prsalikut/wro-2026/other/prototyping/_final_montage.jpg

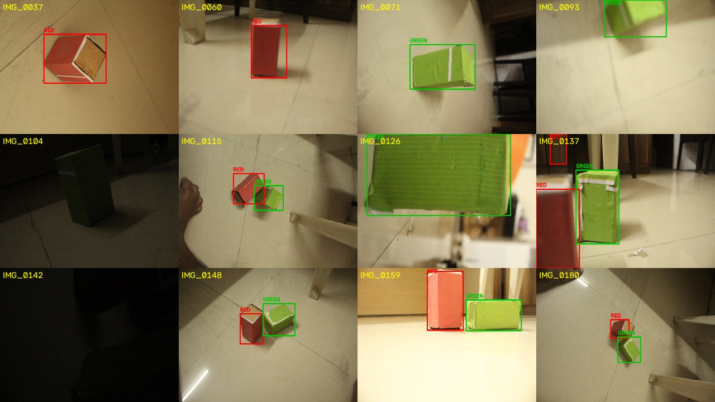
other/prototyping/_final_montage.jpg
