prsalikut/wro-2026/dataset/wro_dataset/_review_sheet_1.jpg

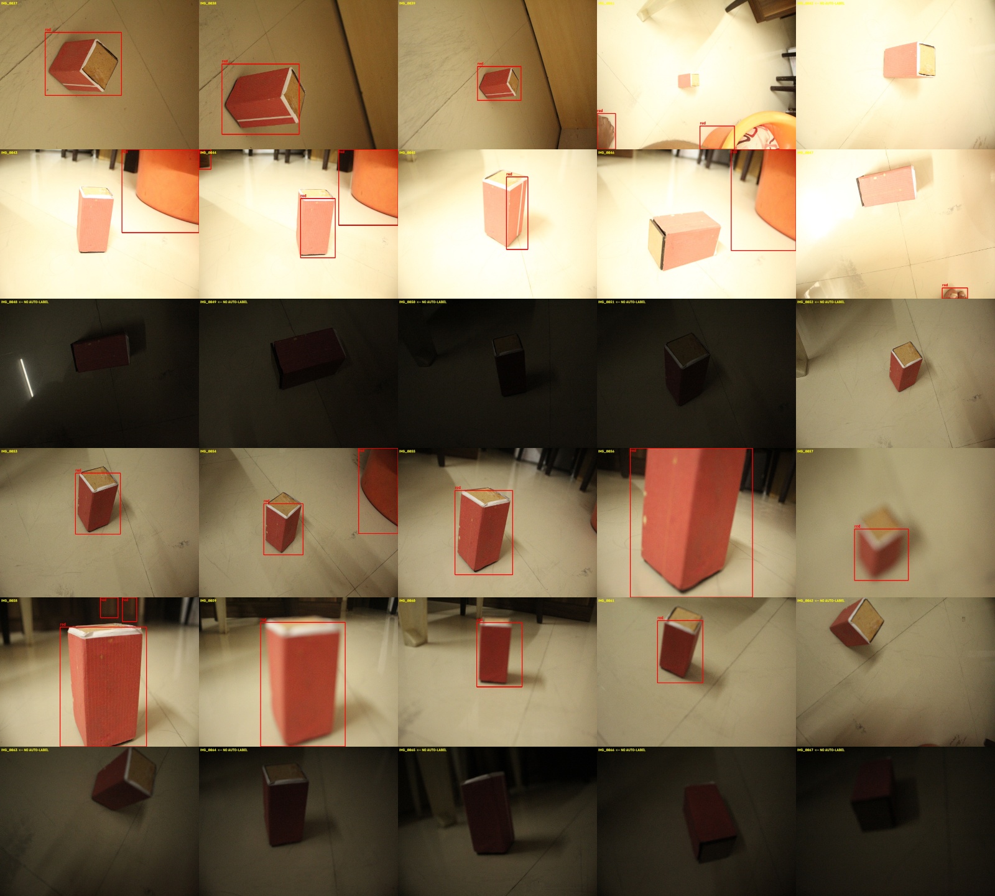
dataset/wro_dataset/_review_sheet_1.jpg
