prsalikut/wro-2026/dataset/wro_dataset/train/images/IMG_0037.jpg

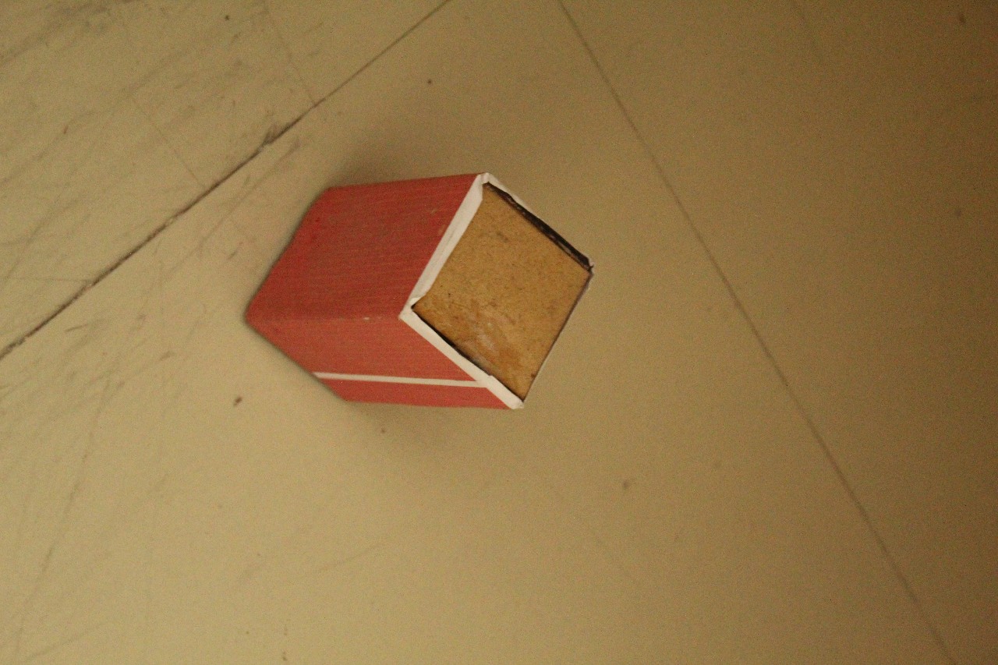
dataset/wro_dataset/train/images/IMG_0037.jpg
