prsalikut/wro-2026/dataset/wro_dataset/train/images/IMG_0073.jpg

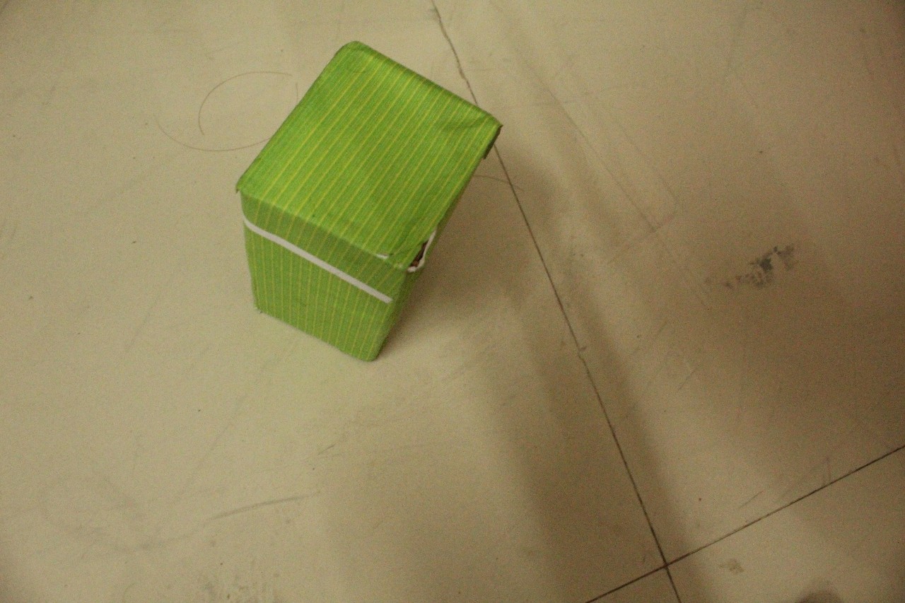
dataset/wro_dataset/train/images/IMG_0073.jpg
