prsalikut/wro-2026/dataset/wro_dataset/train/images/IMG_0081.jpg

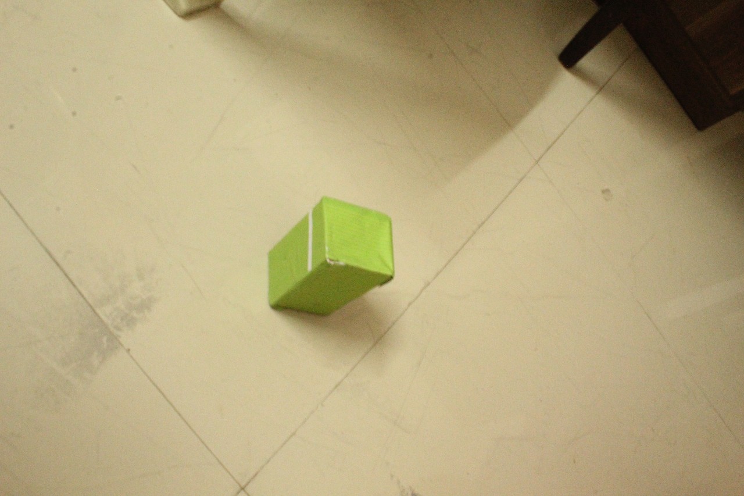
dataset/wro_dataset/train/images/IMG_0081.jpg
