prsalikut/wro-2026/dataset/wro_dataset/train/images/IMG_0092.jpg

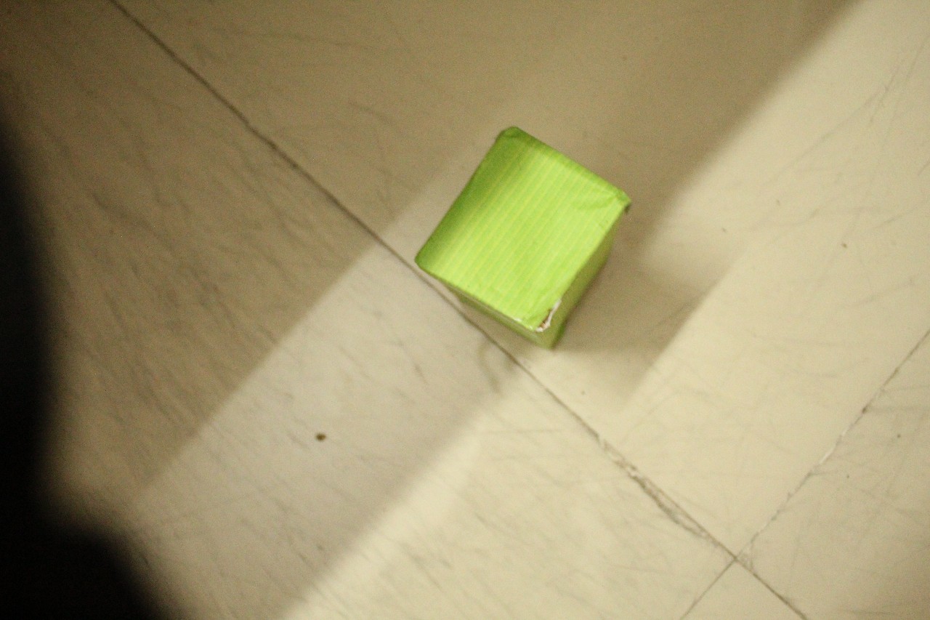
dataset/wro_dataset/train/images/IMG_0092.jpg
