prsalikut/wro-2026/dataset/wro_dataset/train/images/IMG_0113.jpg

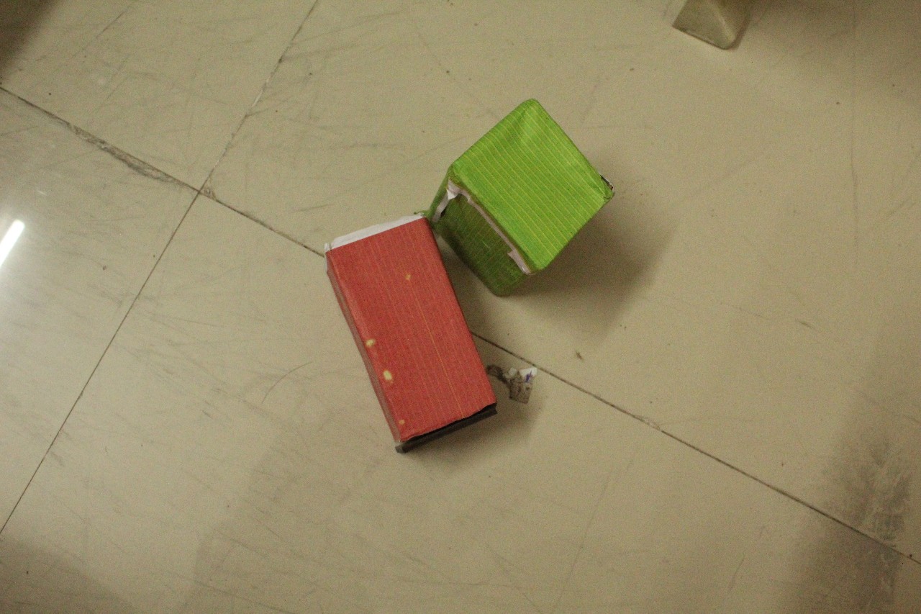
dataset/wro_dataset/train/images/IMG_0113.jpg
