prsalikut/wro-2026/dataset/wro_dataset/train/images/IMG_0167.jpg

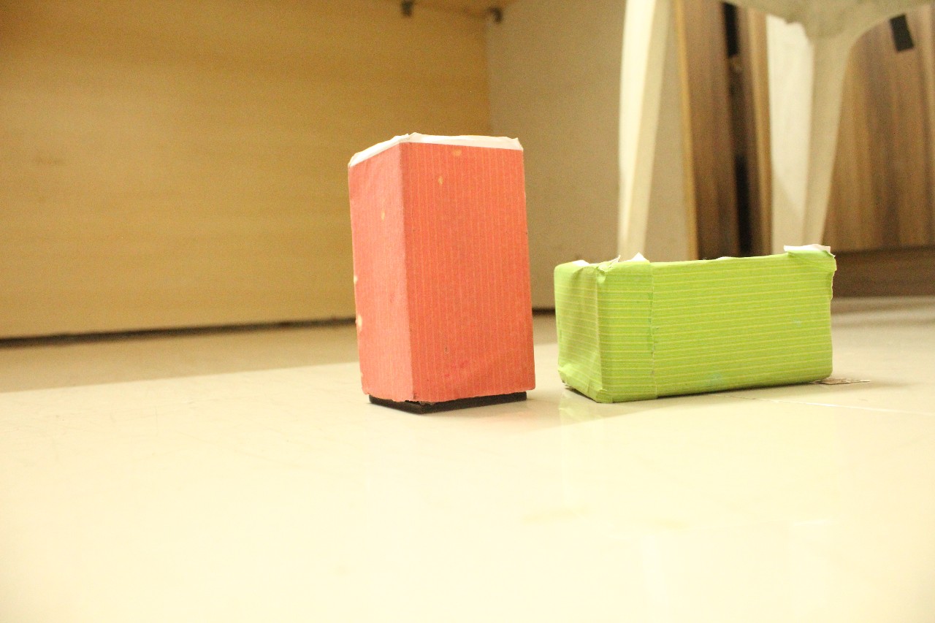
dataset/wro_dataset/train/images/IMG_0167.jpg
