prsalikut/wro-2026/dataset/wro_dataset/train/images/IMG_0169.jpg

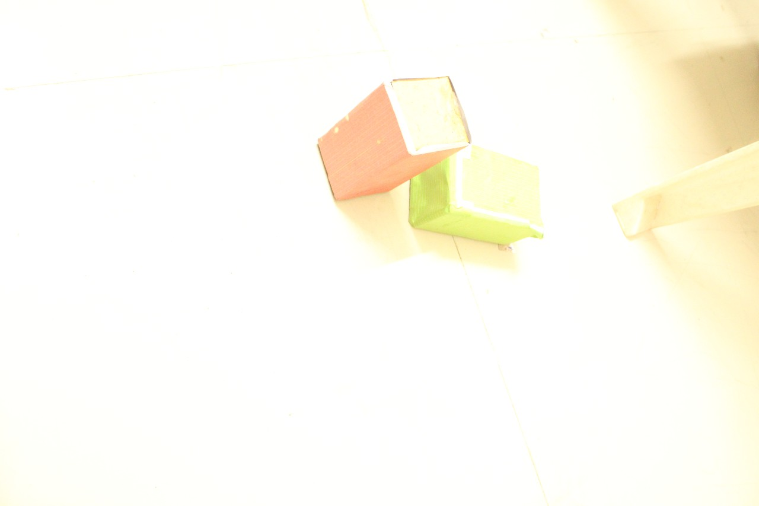
dataset/wro_dataset/train/images/IMG_0169.jpg
