prsalikut/wro-2026/dataset/wro_dataset/train/images/IMG_0180.jpg

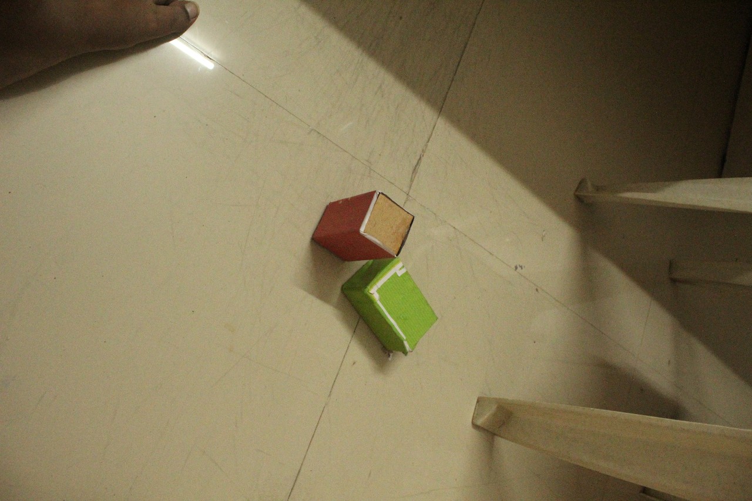
dataset/wro_dataset/train/images/IMG_0180.jpg
