prsalikut/wro-2026/dataset/wro_dataset/valid/images/IMG_0112.jpg

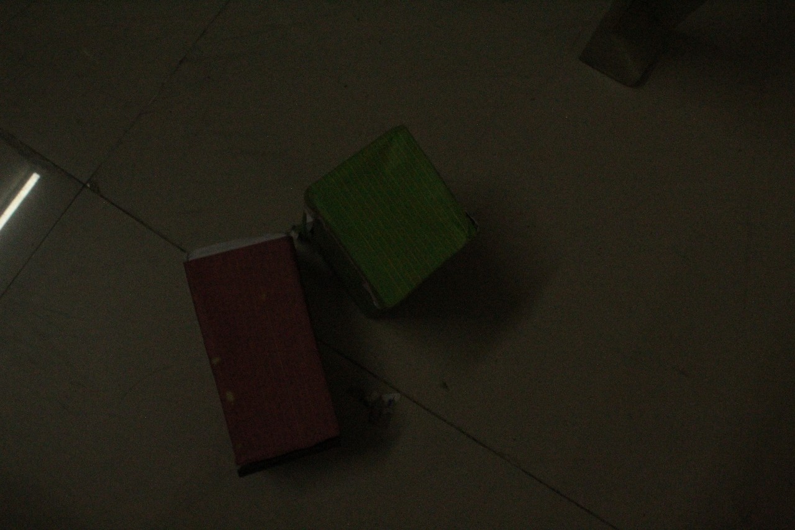
dataset/wro_dataset/valid/images/IMG_0112.jpg
