prsalikut/wro-2026/dataset/wro_dataset/valid/images/IMG_0122.jpg

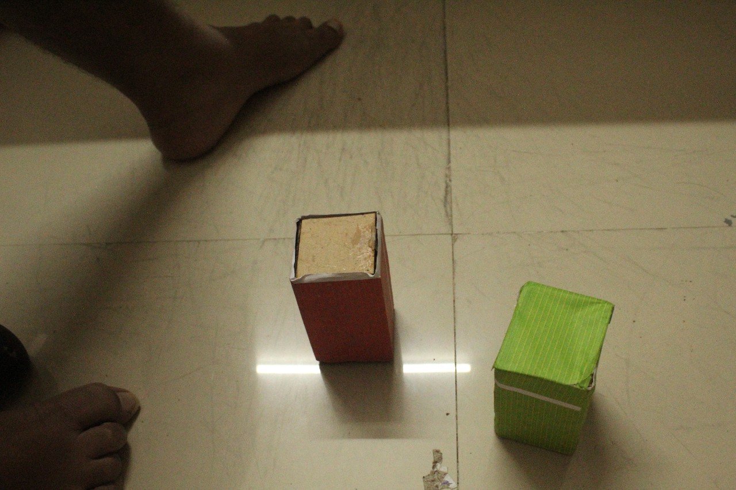
dataset/wro_dataset/valid/images/IMG_0122.jpg
