prsalikut/wro-2026/dataset/wro_dataset/valid/images/IMG_0171.jpg

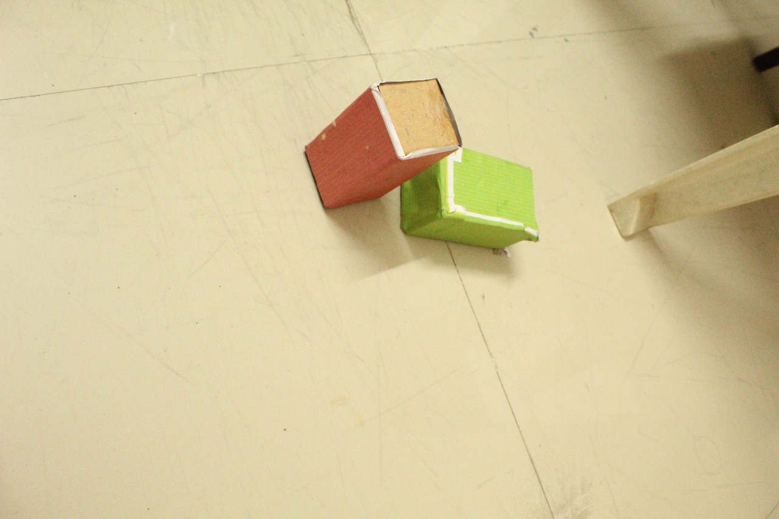
dataset/wro_dataset/valid/images/IMG_0171.jpg
