prsalikut/wro-2026/other/dataset/wro_dataset/review/IMG_0046.jpg

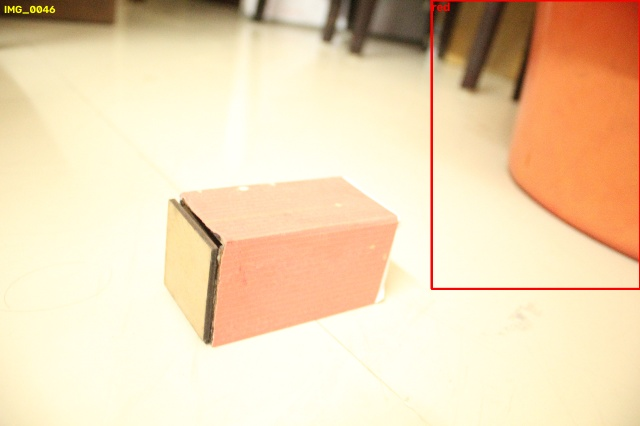
other/dataset/wro_dataset/review/IMG_0046.jpg
