prsalikut/wro-2026/other/dataset/wro_dataset/review/IMG_0064.jpg

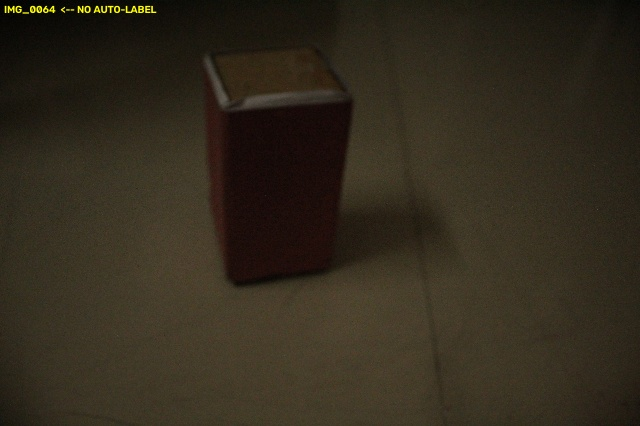
other/dataset/wro_dataset/review/IMG_0064.jpg
