prsalikut/wro-2026/other/dataset/wro_dataset/train/images/IMG_0095.jpg

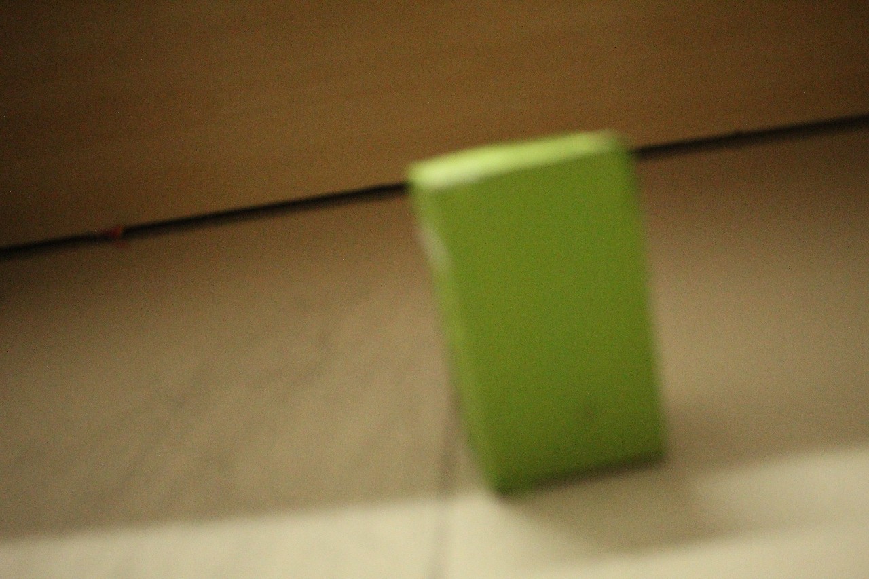
other/dataset/wro_dataset/train/images/IMG_0095.jpg
