prsalikut/wro-2026/other/dataset/wro_dataset/train/images/IMG_0131.jpg

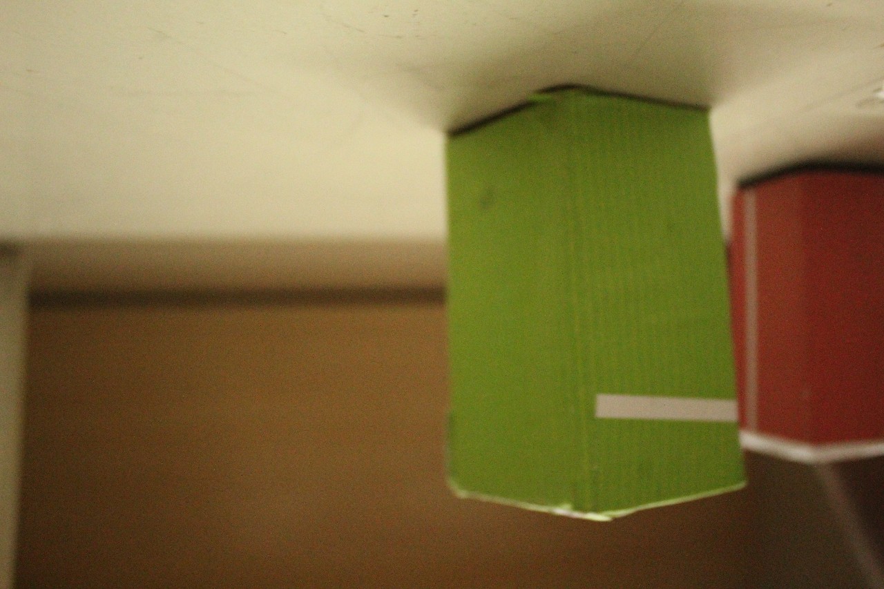
other/dataset/wro_dataset/train/images/IMG_0131.jpg
