prsalikut/wro-2026/other/dataset/wro_dataset/train/images/IMG_0136.jpg

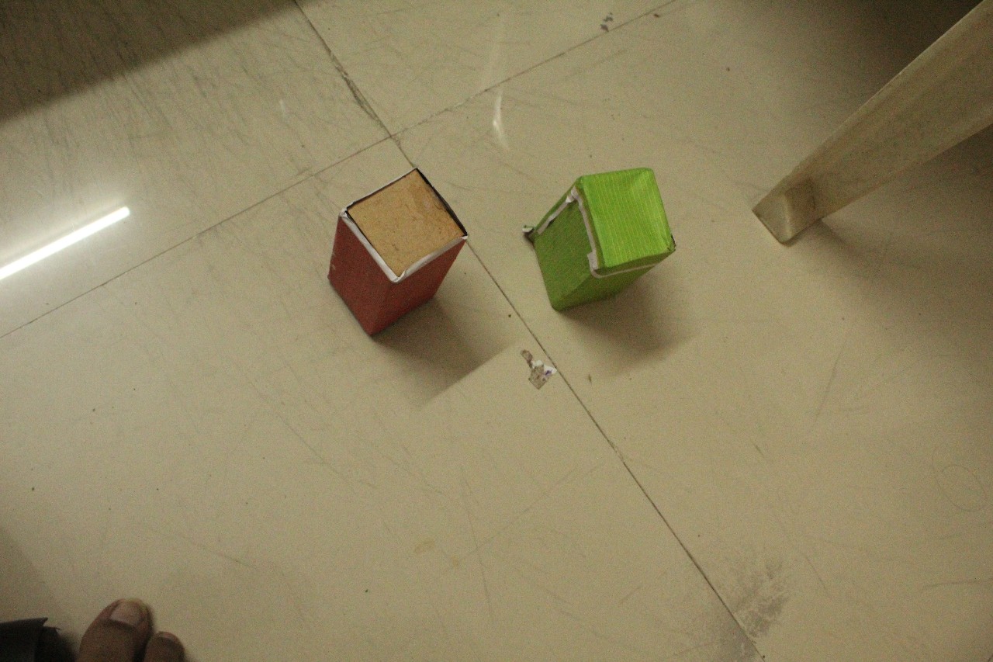
other/dataset/wro_dataset/train/images/IMG_0136.jpg
