prsalikut/wro-2026/other/dataset/wro_dataset/train/images/IMG_0165.jpg

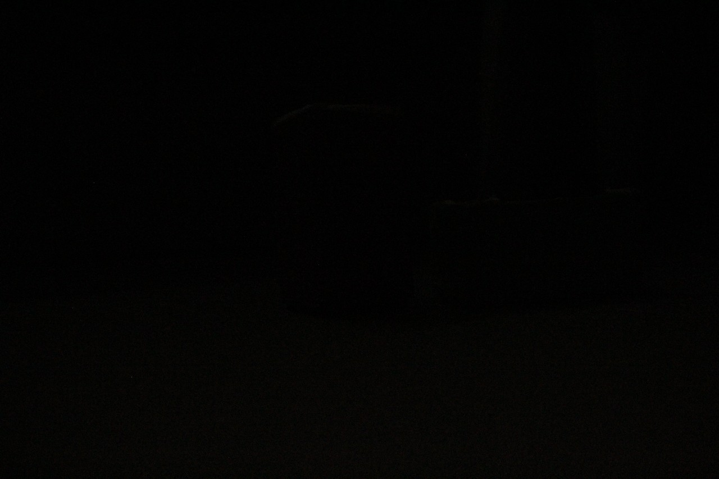
other/dataset/wro_dataset/train/images/IMG_0165.jpg
