prsalikut/wro-2026/other/dataset/wro_dataset/train/images/IMG_0173.jpg

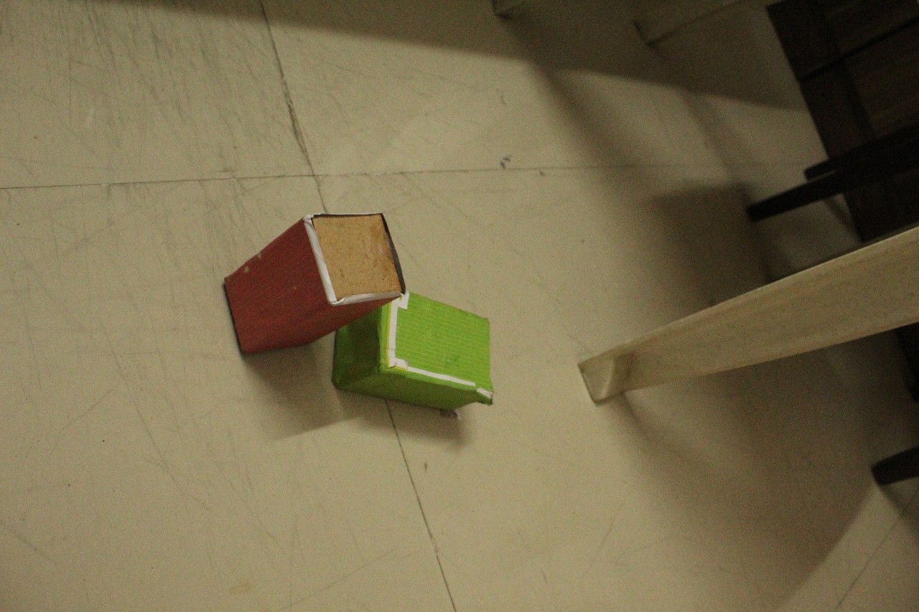
other/dataset/wro_dataset/train/images/IMG_0173.jpg
