prsalikut/wro-2026/other/dataset/wro_dataset/valid/images/IMG_0038.jpg

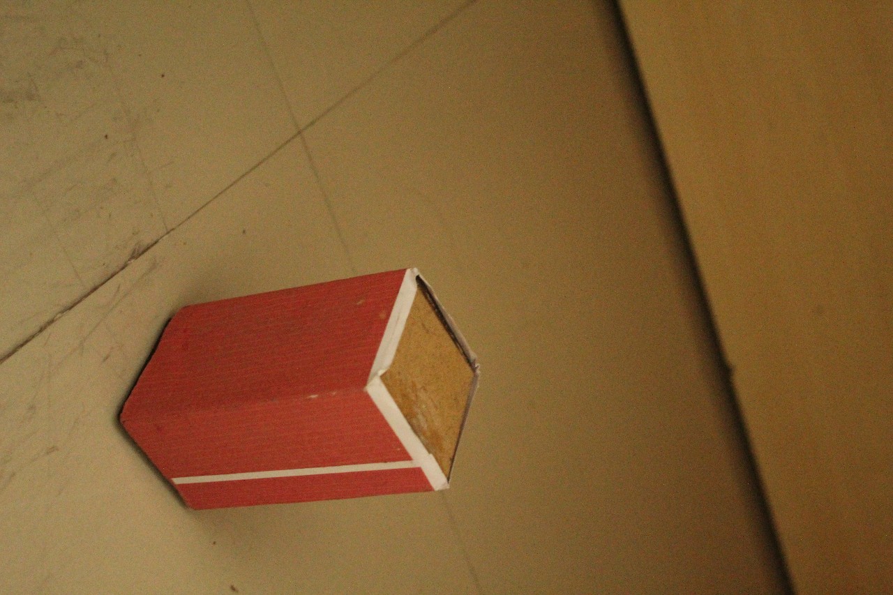
other/dataset/wro_dataset/valid/images/IMG_0038.jpg
