prsalikut/wro-2026/other/dataset/wro_dataset/valid/images/IMG_0077.jpg

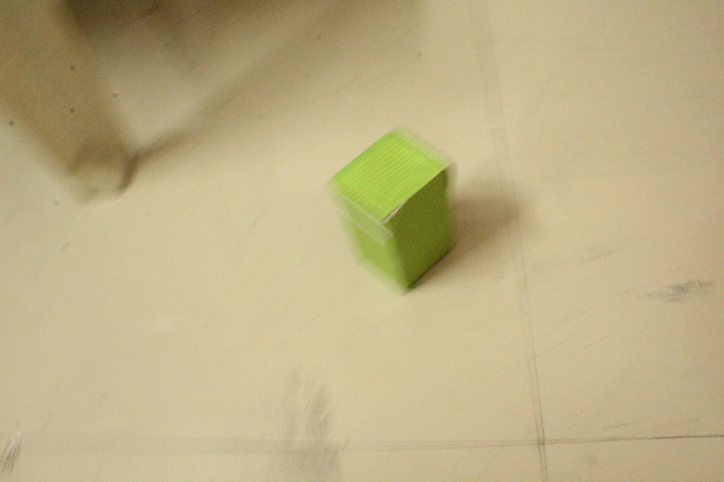
other/dataset/wro_dataset/valid/images/IMG_0077.jpg
