prsalikut/wro-2026/other/screenshots/pi_out148.jpg

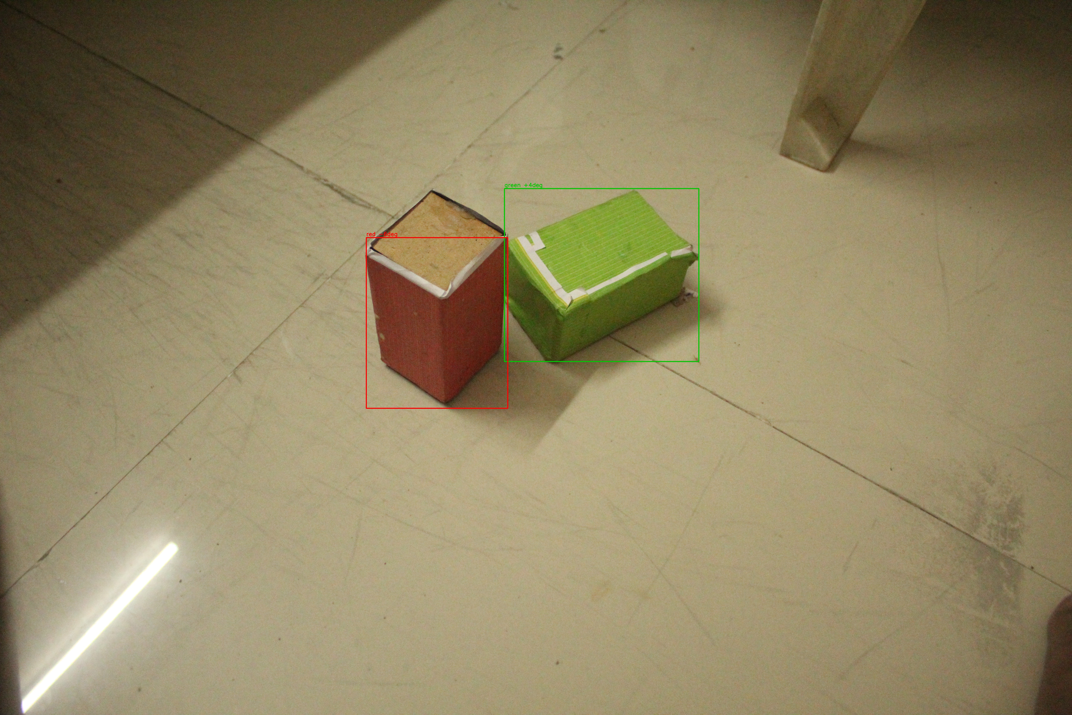
other/screenshots/pi_out148.jpg
