prsalikut/wro-2026/other/screenshots/pi_raw.jpg

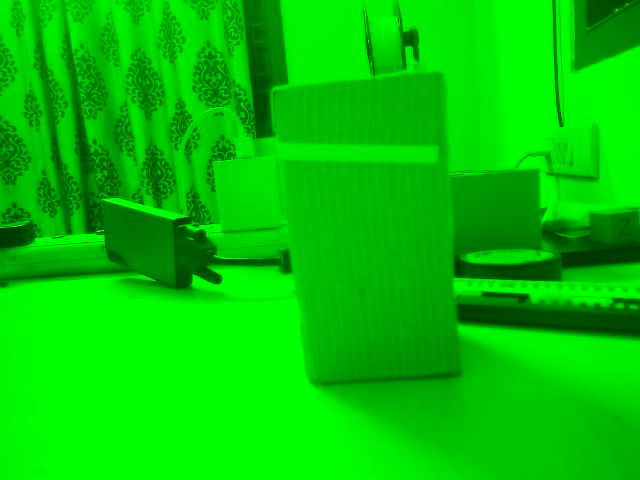
other/screenshots/pi_raw.jpg
