prsalikut/wro-2026/prototyping/_wb_compare.jpg

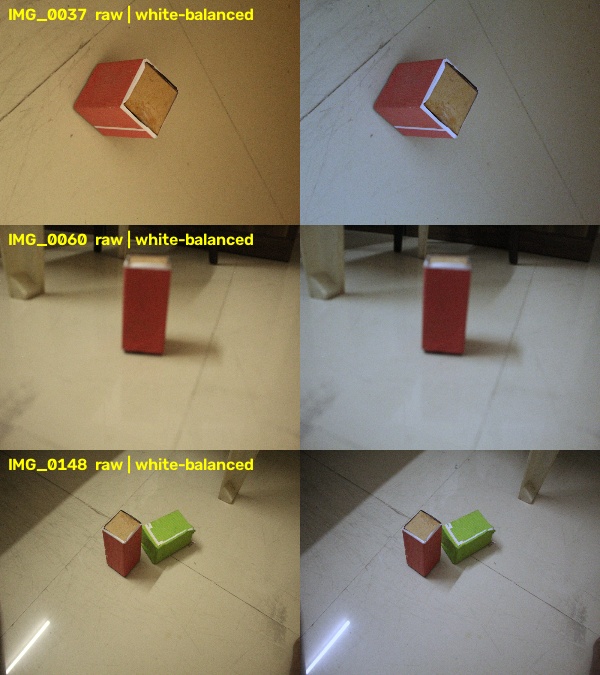
prototyping/_wb_compare.jpg
