prsalikut/wro-2026/screenshots/pi_live3.jpg

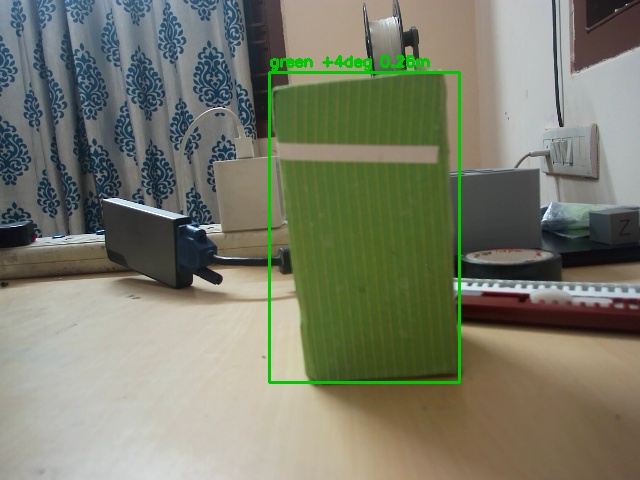
screenshots/pi_live3.jpg
