prsalikut/wro-2026/prototyping/test_frame.jpg

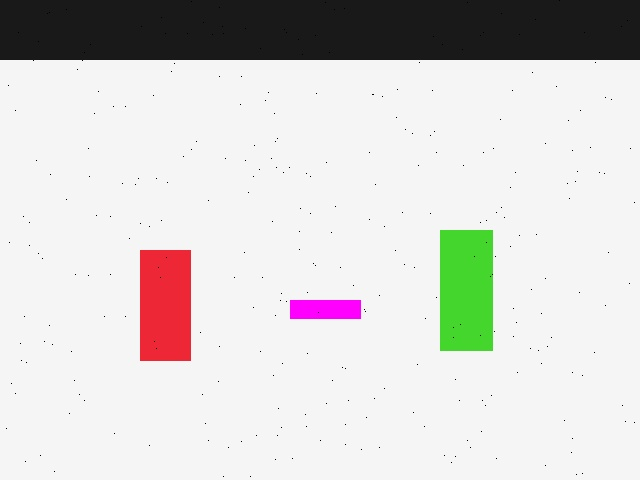
prototyping/test_frame.jpg
