prsalikut/wro-2026/(commit log)

2026-07-19 WRO 2026 sign detection stack
    Perception + steering stack for the Future Engineers self-driving car:
    red/green pillar detection, LiDAR fusion, and serial steering control.
    Comments stripped from all source files. Adds setup instructions,
    .gitignore (excludes the ~2 GB training image set), and .gitattributes
    to keep shell scripts LF so they run on the Pi.
2026-07-29 Manual RC firmware v2, arm/E-stop handling, viz updates
    Extend the steering firmware with the drive/arm command set, update the
    serial link and steering node to match, and refresh the viz server and
    flashing docs.
2026-07-30 Remove digital control UI from main
    Drop browser dashboard/RC (viz_server) and the Tailscale proxy so main
    is perception + autonomous steering only. No gamepad/Steam Deck teleop.
2026-07-30 Restore dashboard without RC/touch controls
    viz_server.py restored from history with all gamepad/touch RC
    drive stripped - only the 3-mode panel dashboard (desktop/assembly/final)
    remains. Also restored proxy.py (updated for hostname).
2026-07-30 Restore RC drive with Steam Deck / Firefox gamepad fixes
    - Gamepad polling fallback (scans every 1s + manual button)
    - Triggers read from both analog buttons AND axes (fixes Steam Deck)
    - Escape = disarm, Enter = engage (guarded)
    - Flatpak permission note for SteamOS Firefox
    - Default page remains the 3-mode dashboard (desktop/assembly/final)
    - RC page at /rc with gamepad debug tester
2026-08-23 Restructure to WRO template; rebuild open-round driver and sensor stack
    Repository now follows the WRO Future Engineers template layout (src/, schemes/,
    models/, t-photos/, v-photos/, video/, other/) with placeholders naming the
    documentation still required for scoring. README rewritten to match the current
    build and the >5000 character requirement.
    Open round driver:
    - lane centring is proportional on left/right range, sonar first with lidar as
    per-side fallback
    - corners trigger on the mat's colour lines, with the first colour seen locked in
    so a corner's exit line cannot fire a second turn; wall distance stays as backup
    - optional gyro: 90 degree corner exit by degrees swept, plus he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
2026-08-23 Fuse ultrasonic, lidar and IMU rather than ranking them
    Lane centring took sonar when present and lidar otherwise, which threw away a
    credible lidar reading and hid disagreement between the two. Sides are now a
    weighted blend when the sensors agree within fuse_tol_m, falling to sonar alone
    when they do not, with the disagreement published in open_status.
    Adds a derivative term on the centring error. Its rate is a heading estimate the
    ranges can produce unaided, so the car damps its approach to a wall without an
    IMU, and complements heading hold when one is fitted.
    Sensor roles are documented in DEPLOY.md: ultrasonics carry side range, lidar
    carries front distance and the obstacle round whe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
2026-08-23 Move the sonar trigger from D4 to D12
    The four HC-SR04 are wired with their shared trigger on D12, not D4. D12 is
    otherwise free on this build: D2 drives the servo, D5-D8 the BTS7960, and the
    echoes stay on A0-A3. The sketch pulls in no SPI, so nothing else wants MISO.
    Only the trigger moves. The echoes must remain on A0-A3 because the capture
    depends on all four sharing PORTC, where one PCINT1 vector times them together.
2026-08-23 Add a MODE button, and stop a held button from repeating
    START keeps its toggle, and a second button on GPIO27 selects which round it
    launches. That takes the dashboard off the critical path on the field: the car
    can be set to the open or obstacle round with the buttons alone. MODE is refused
    while a round is running, since swapping the driver under a moving car is never
    what the press meant, and the choice is published in start_status.
    Debouncing moves into an Edge object, one per button. It was a single set of
    timers on the node, which two buttons cannot share: a press on either would have
    consumed the other's hold-off window.
    The press detector now disarms until the button reads release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
2026-08-23 Add a one-shot check across every sensor topic
    smoke_test only samples traffic_signs, so bringing up the car meant echoing each
    topic by hand and eyeballing whether the numbers moved. check_all subscribes to
    the camera, lidar, bridge, IMU, buttons and all four sonars at once and prints
    message counts, rates and a per-sensor sanity note.
    It reports a sensor that publishes a constant value as FROZEN rather than
    present. A sonar with its echo unwired still produces a topic at full rate, and
    counting messages alone would call that healthy.
    Read-only: it commands neither servo nor motor, so it is safe with the car on
    the mat. Exit status is non-zero when a required component is down, so a launc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
2026-08-23 Add a one-command deploy-and-check, and a /car slash command
    Bringing the car up meant pasting four shell blocks from DEPLOY.md in order and
    reading each result before running the next. deploy.sh does the sequence --
    optional Nano flash, scp, colcon build, restart, sensor check -- and stops at the
    first step that fails rather than carrying on against a stale build.
    Each step is skippable. A run that dies at the build can resume at --check-only
    instead of copying everything again.
    It checks it can reach the Pi before doing anything, because every later failure
    looks the same from a machine that is simply not on the tailnet. That case prints
    what to check and exits, since it is a network pro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
2026-08-23 Write the parts list and connection tables into schemes/
    The folder held a stub naming an MPU6050 on the Pi I2C bus, which is no longer
    the build: the MPU is out and a BNO055 replaces it, the sonars and the two
    buttons were never listed, and the trigger pin has since moved to D12. Anyone
    rebuilding from that table would have wired the wrong car.
    Records what the firmware and the nodes actually expect: every part, the Pi
    header and Nano pin assignments, the three power domains sharing one ground, and
    the constraints that are silent when broken -- the A0-A3 echo order, D9/D10
    being unusable under Servo.h, and the sonar order that reads plausibly when
    swapped.
    The drawn diagram the rules requ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
2026-08-25 Stop discarding the sonar stream, and adopt the Pi's newer bridge
    The sonar topics were publishing at 0.2 Hz against an 18 Hz firmware stream.
    _write_read() called reset_input_buffer() before every command, so with USON
    running it threw away the entire sonar feed between commands, and the sonar
    node only ever saw the occasional reply.
    ArduinoLink now parks unprompted "US ..." lines instead of dropping them, and
    steps over them when it is waiting for a command reply -- a one-shot US reply
    is byte-identical to a broadcast, so only the US verb may claim one. The bridge
    drains them each tick, before the manual-mode early return, and republishes
    them on arduino_reply. Measured 0.2 Hz -> 18.1 Hz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
2026-08-25 Give the container a GPIO backend, and make flash.sh executable
    start_button failed with "no usable GPIO backend: No module named 'gpiod'", so
    both buttons were dead and start_status reported no_gpio. python3-libgpiod is
    the v1 API the node actually uses (gpiod.Chip/get_line/LINE_REQ_*). With it in
    the image both buttons claim: start on line 17, mode on line 27, and
    start_status reads {"state": "waiting", "mode": "open"}.
    flash.sh was committed non-executable while deploy.sh --flash invokes it
    directly, so that path could never have run.
2026-08-25 Centre on ultrasonics only, and record what the bench run found
    sonar_weight 0.7 -> 1.0, so side centring takes the ultrasonic reading outright
    rather than blending the lidar in.
    This is requested behaviour, and it is worth being explicit that the hardware
    does not currently support it. Measured on the car: the right sonar sat at
    exactly 0.43 m for 213 consecutive samples while the lidar put the nearest
    object on that side at 2.94 m, and the front sonar read ~0.93-1.47 m against a
    lidar front of 2.27 m. Front being stuck under turn_m (1.10) means the car
    believes it is at a corner permanently -- it turns into the wall, and
    reverse_enable then backs it into the wall behind, which is the obse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
2026-08-25 Add vision, mapping and calibration tooling for the open round
    Splits the open-round logic into a testable core, adds camera-based
    wall detection with ground geometry and range fusion, and brings in
    offline simulation, calibration and recording tools plus CI.
